tsukolsky/theWeather.system/theWeather.systemPCB/theWeather.system_A_topRoute.JPG

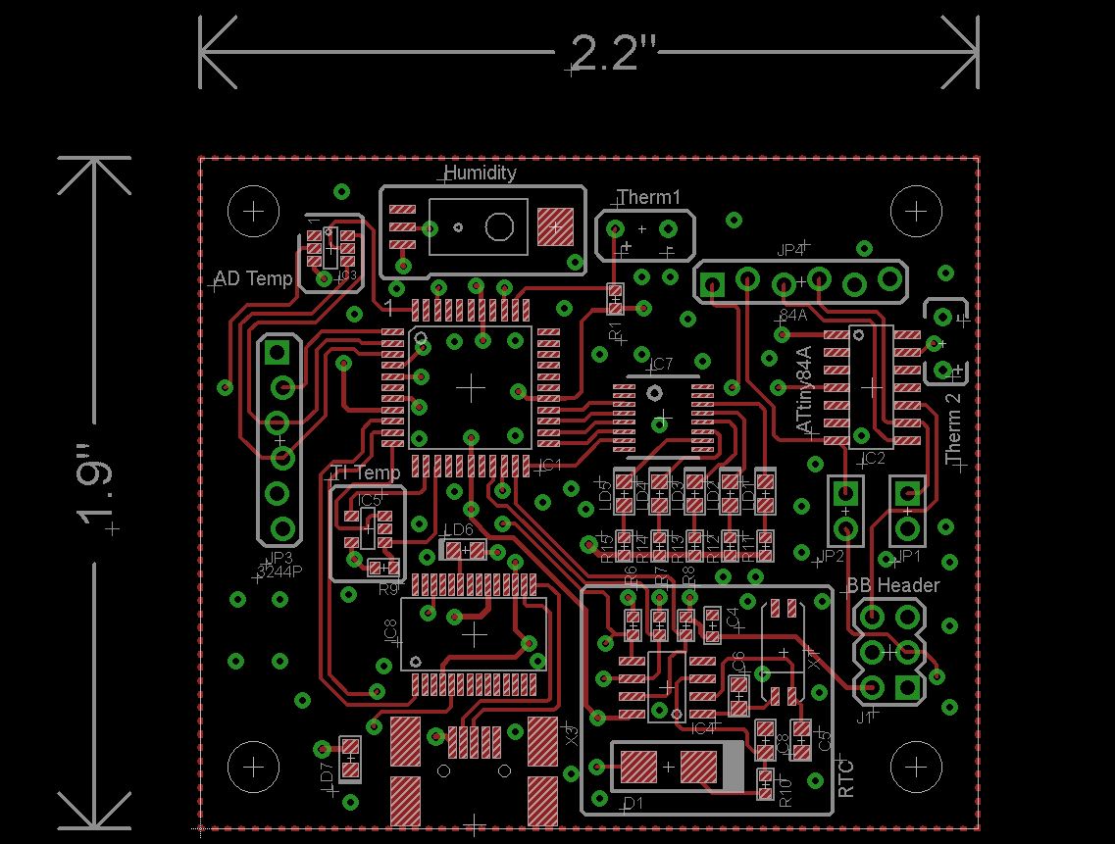
theWeather.systemPCB/theWeather.system_A_topRoute.JPG
