tsukolsky/theWeather.system/theWeather.systemPCB/README.md

This folder contains Eagle files and zip files (for oshPark and batchPCB for the board layout and schematic. For quick viewing, see the .pdf versions and .jpg images for an overview
