tsukolsky/theWeather.system/AVR_CODE/README.md

ATtiny84A_dev has the code for the onboard ATtiny, *_breadboard has the code used for the 324P on a breadboard using PDIP package, *_324P contains code for actual implementation on PCB for 324PA
