tsukolsky/theWeather.system/theWeather.systemPCB/theWeather.system_A_bottomRoute.JPG

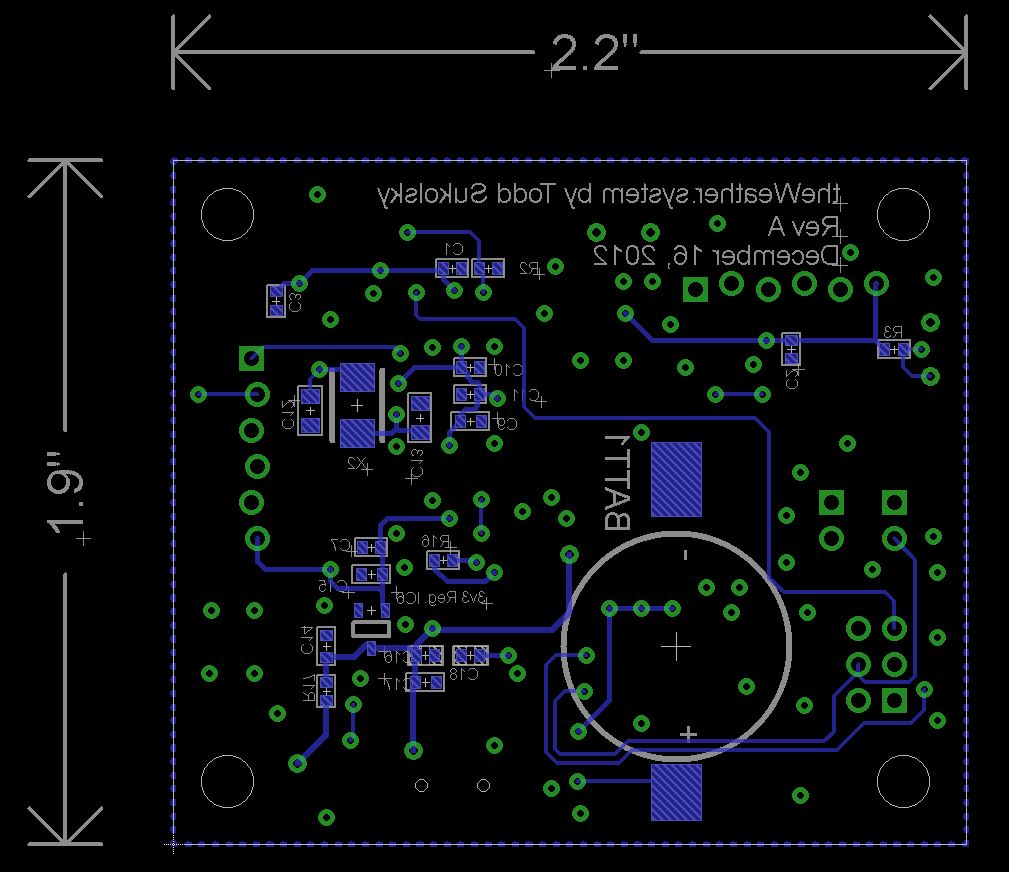
theWeather.systemPCB/theWeather.system_A_bottomRoute.JPG
