tsukolsky/theWeather.system/Files/theWeather_A_sch.pdf

## ATMEGA324P-AU

## ATtiny84A: Temperature


On-Board Temp Sensor--AD

See page 2 for DEBUGx wires

On-Board Temp Sensor--TI

Pull-Ups for I2C
2.2k for fast, 4.7k and 10k possibilities

Processing, Temperature, Humidity, RTC

5V->3V3

## DEBUG LEDS


UART/USB, Power Regulator, LED Arrays, Header to BB
