tsukolsky/theWeather.system/Files/theWeather_A_bottom.pdf

theWeather.system by Todd Sukolsky
Rev A
December 16, 2012
