tsukolsky/theWeather.system/Files/megaAVRcode/stdtypes.h

/*******************************************************************************\
| stdtypes.h
| Author: Todd Sukolsky
| Collaborator: Michael Gurr
| Initial Build: 7/31/2012
| Last Revised: 7/31/2012
| Created by Mark Taylor: Permitted for use by Todd Sukolsky
|================================================================================
| Description: Declares types for the ATMEGA324PA microcontroller
|--------------------------------------------------------------------------------
| Revisions:
|================================================================================
| *NOTES:
\*******************************************************************************/

#ifndef STDTYPES_H_
#define STDTYPES_H_

/* ------------------------------------------------------------ */
/*					General Type Declarations					*/
/* ------------------------------------------------------------ */

#define	fFalse	0
#define	fTrue	(!fFalse)

#define	BOOL	uint8_t
#define	BYTE	uint8_t
#define	WORD	uint16_t

/* ------------------------------------------------------------ */
/*					Object Class Declarations					*/
/* ------------------------------------------------------------ */



/* ------------------------------------------------------------ */
/*					Variable Declarations						*/
/* ------------------------------------------------------------ */

#endif /* STDTYPES_H_ */

/************************************************************************/
