tsukolsky/theWeather.system/(commit log)

2012-12-13 Almost finished
    [theWeather_A.sch]
2012-12-13 Finished schematic
    [theWeather_A.brd, theWeather_A.sch]
2012-12-14 Almost finished with first layout
    [theWeather_A.brd, theWeather_A.sch]
2013-03-02 Current progress: board mounted and working, only thing not currently implemented is communication with ATtiny and ATmega324PA
    [theWeather_A.brd, theWeather_A.sch]
2013-03-03 Fixing issue with AVR code
    [theWeather_A.brd, theWeather_A.sch]
2013-04-24 Tweaked main code for more ideal situation, doesn't speraticly do things for the sake of doing them. now takes readings, prints, then sleeps for a certain amount of time. Next is SPI and I2C
    [ATmega324PA.h]
2013-04-25 Originally added SPI transfer for ATtiny, then realized that was stupid and it doesn't work wtih SPI, but with TWI(i2c). This will be implemented tomorrow. Miles to go, but it's time to sleep.
    [ATtiny84A.c, atTiny84A.h, stdtypes.h]
2013-04-26 Finished first prototyping for receive uart from the Rasberry Pi. Needs to now be field tested. New Branch
2013-04-27 New/replaced old version with this new one. It has cpp files and all working classes. Sucker communicates with rasberry pi. See headers for more details.
    [ATmega324PA.h, clock.h, eepromGurrDaddy.h, myUart.h, stdtypes.h, theWeather.system_mega.cpp, thermostat.h]
2013-04-28 Moved tiny into new file. Got all of desired functionality except I2C done on mega chip. See Revisions in header for more information
2013-04-28 Made a change to correct WEEK. response. If the system was booted before a new week, and no reading was taken, then the system needs to take a reading so it has somethign to spit out besides the 0 an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
    [clock.h, theWeather.system_mega.cpp, thermostat.h]
